ckgardner25/Venue_Decibel_Meter/Images/Front.png

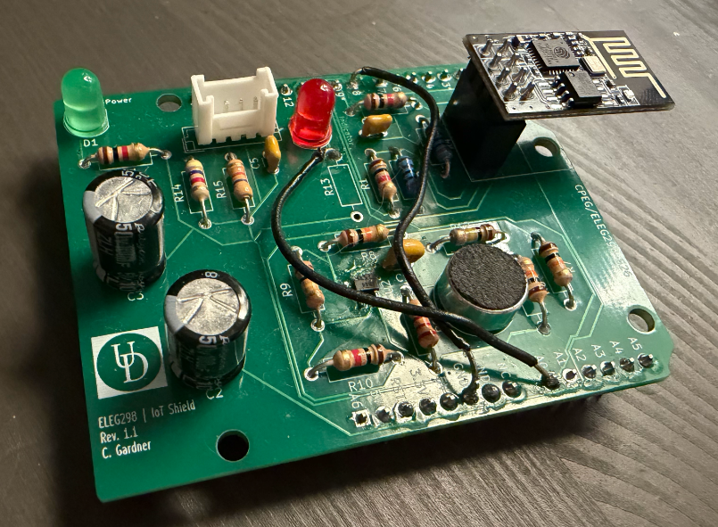
Images/Front.png
