ckgardner25/Venue_Decibel_Meter/Images/Rear.png

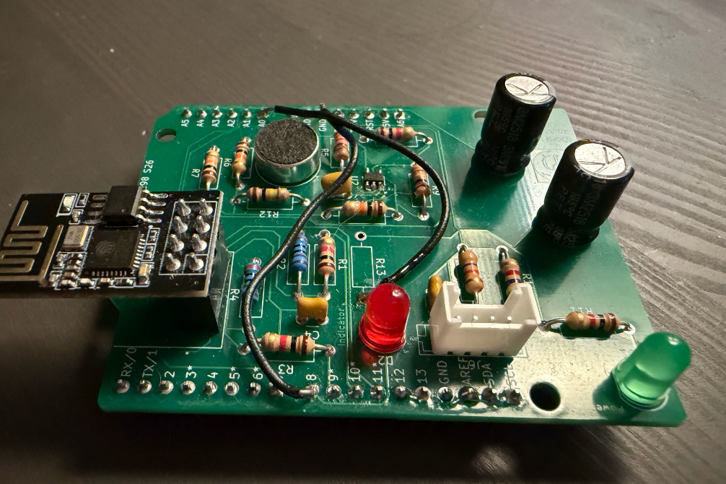
Images/Rear.png
