ckgardner25/Venue_Decibel_Meter/PCB/PCB.png

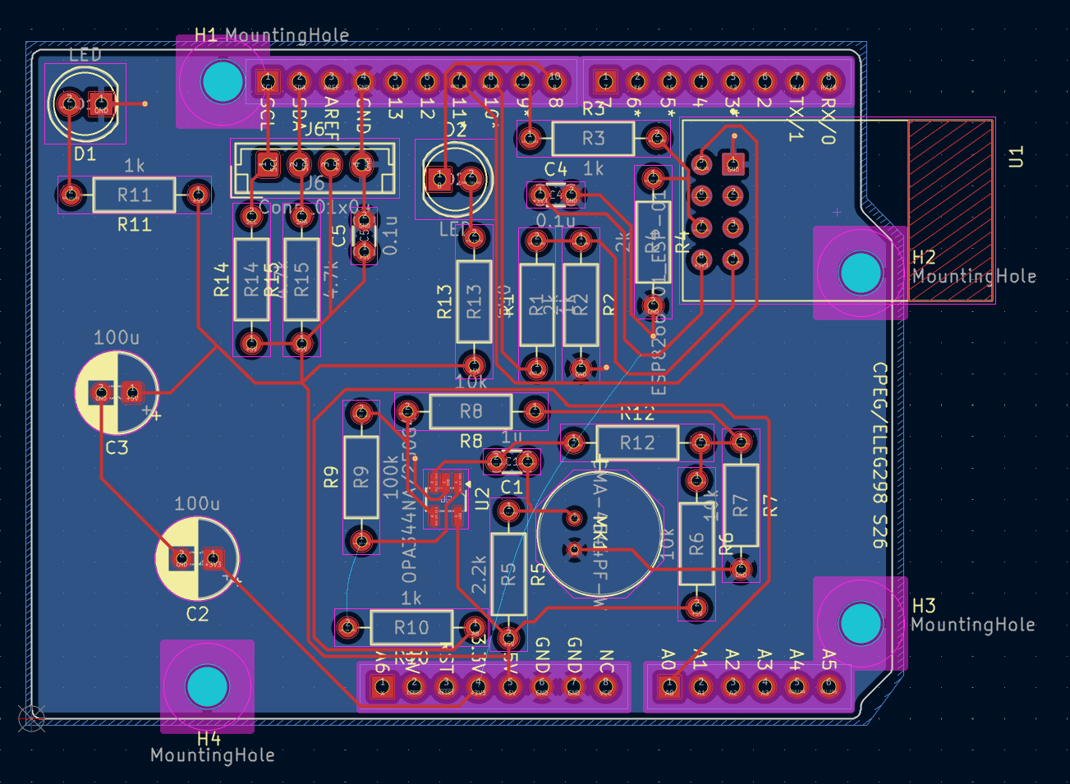
PCB/PCB.png
