ckgardner25/Venue_Decibel_Meter/Schematics/ESP8266 Module.png

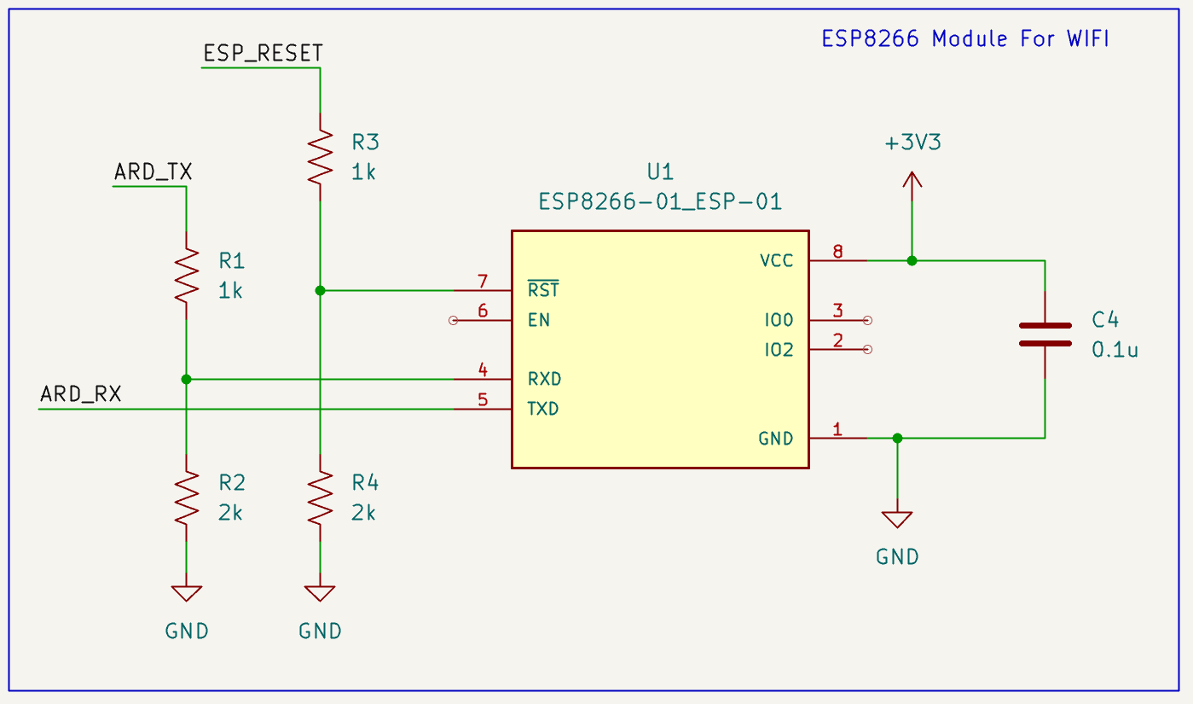
Schematics/ESP8266 Module.png
