ckgardner25/Venue_Decibel_Meter/Schematics/Expansion_Slot.png

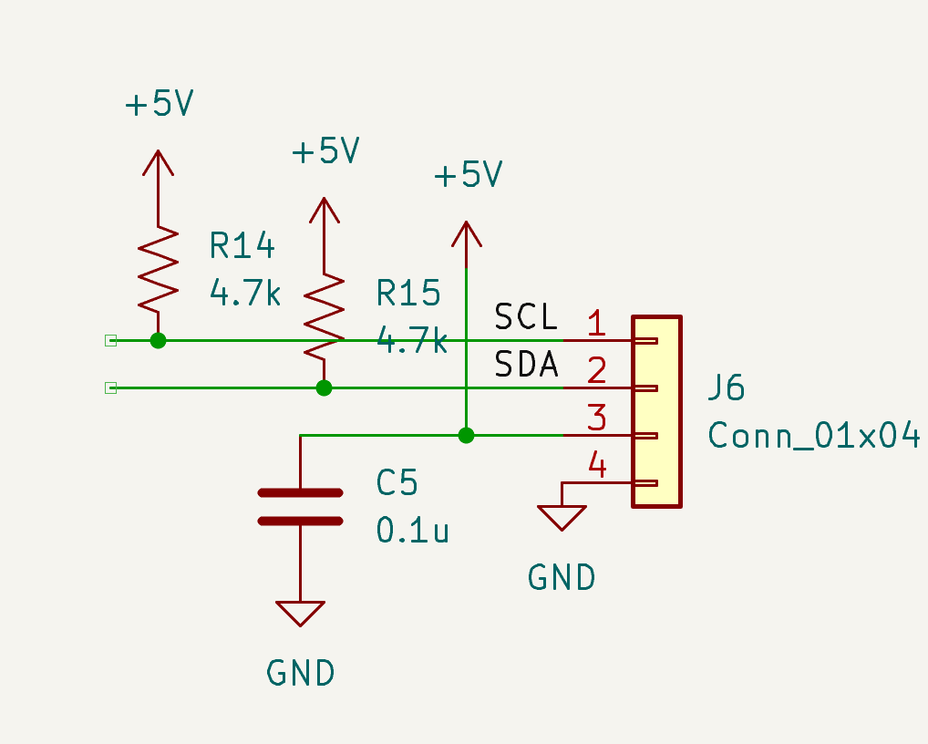
Schematics/Expansion_Slot.png
