ckgardner25/Venue_Decibel_Meter/Schematics/Input_Architecture.png

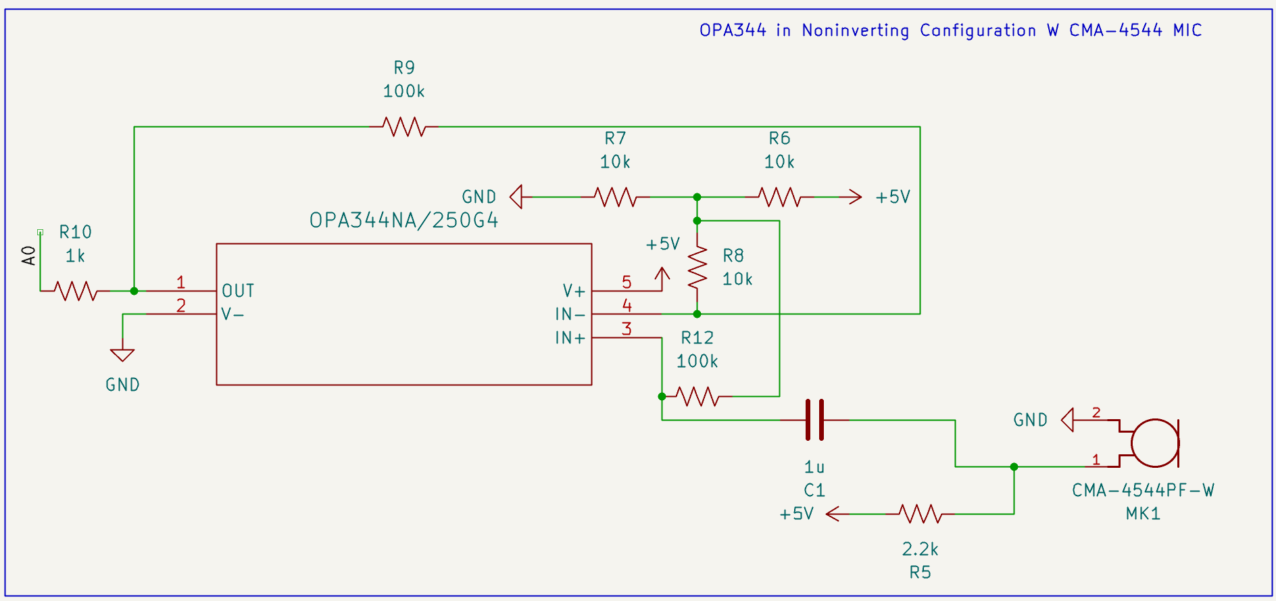
Schematics/Input_Architecture.png
