ckgardner25/Venue_Decibel_Meter/Reports/OscillscopeReadings_Schematics_BOM.pdf

# Venue Audio Monitor

### ELEG298 S26 IOT Device Christopher Gardner 4/29/2026

# Design Issues/Goals

Goals: • Design and Develop a venue audio monitor to comply with city

ordinance on volume
- Have expandable ports for future needs
- Upload via ESP8266 and show with a red LED when dB volume exceed 70+
Issue:
When designing the PCB I mistaken connected the indicator LED directly to 5V leading it to be unable to send a warning flash when too loud. However, as a prototype I designed the LED in a way so that removing R13 and wiring the LED straight to the analog pinout for the mic (A0) to have full functionality.

# Schematic and Description

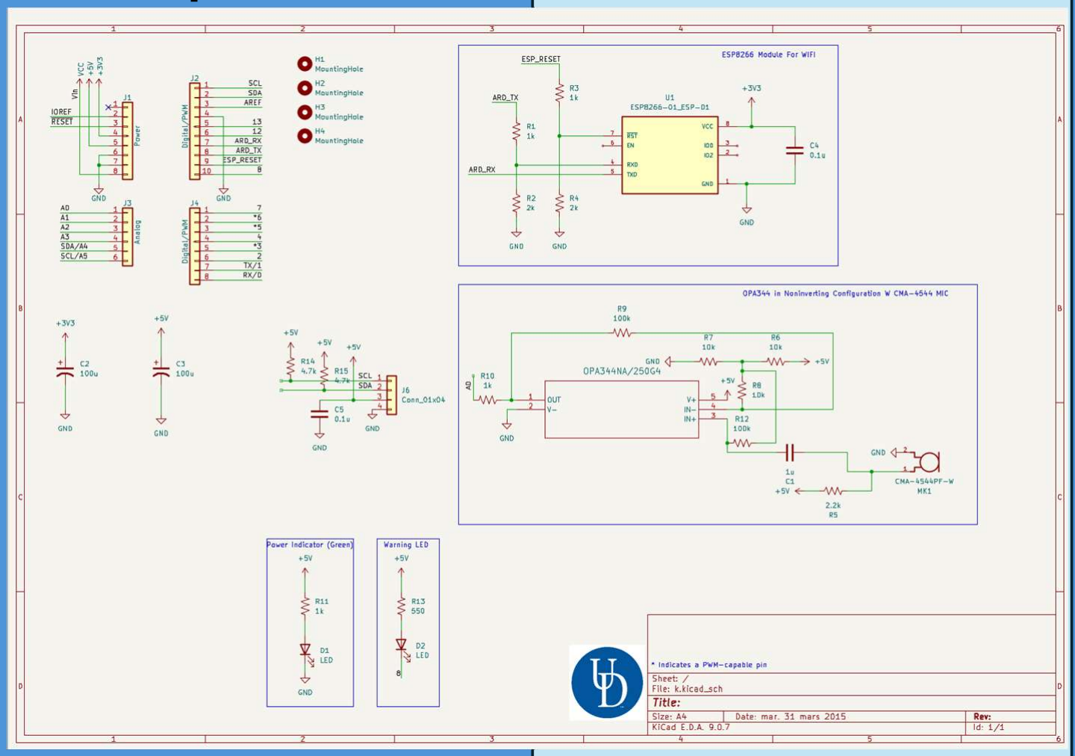
[picture p18: figure]

The IoT shield takes a audio impute via the microphone and boosts the AC signal into a operational amplifier wired in non-inverting bias to create the maximum AC output. This is then taken into the ADC to be processed as a digital signal for the ESP8266 to then take the average of peak-to-peak waves for the conversion to dB for accurate readings. The direct AC signal is also put into the indicator LED to show when the dB exceeds threshold value.

# Operational Amplifier/Microphone Datasheet

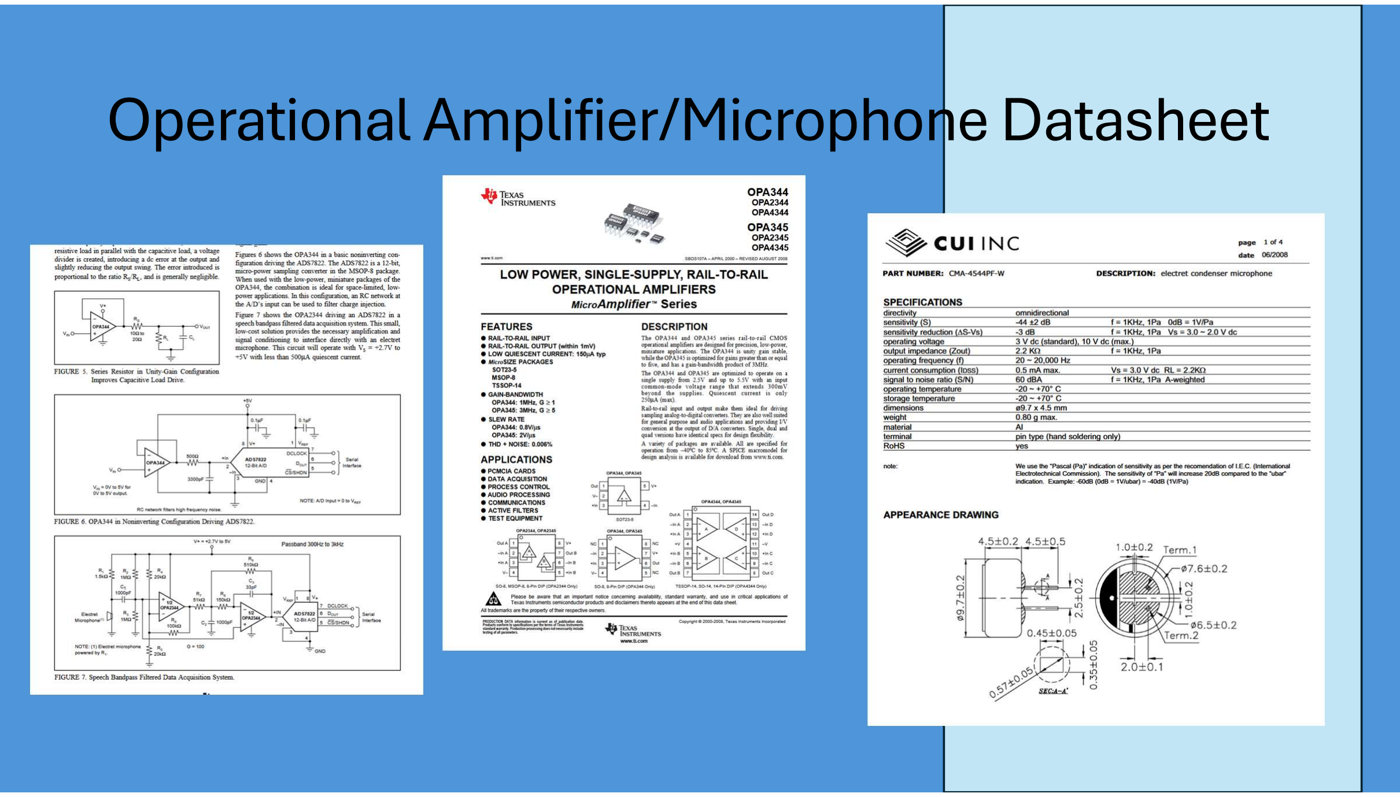
[picture p19: page 4]

# PCB Design

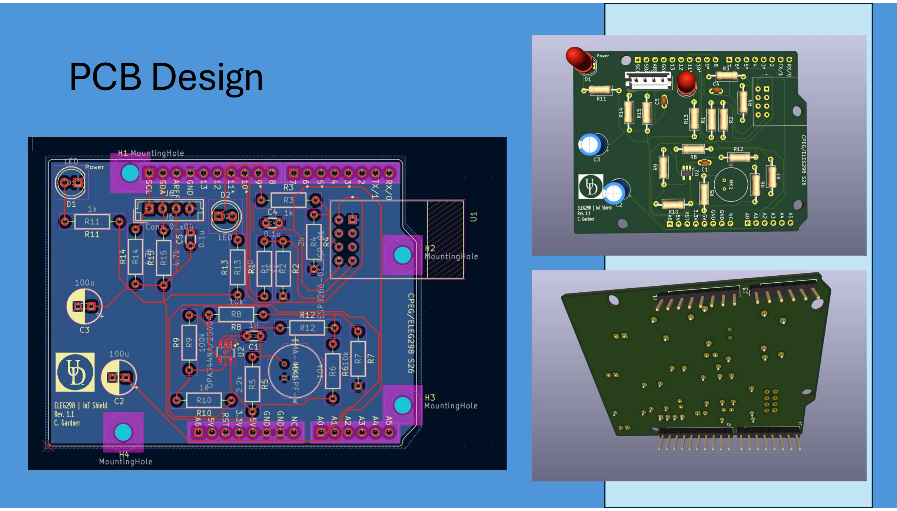
[picture p20: page 5]

# BOM/Stuffing Diagram

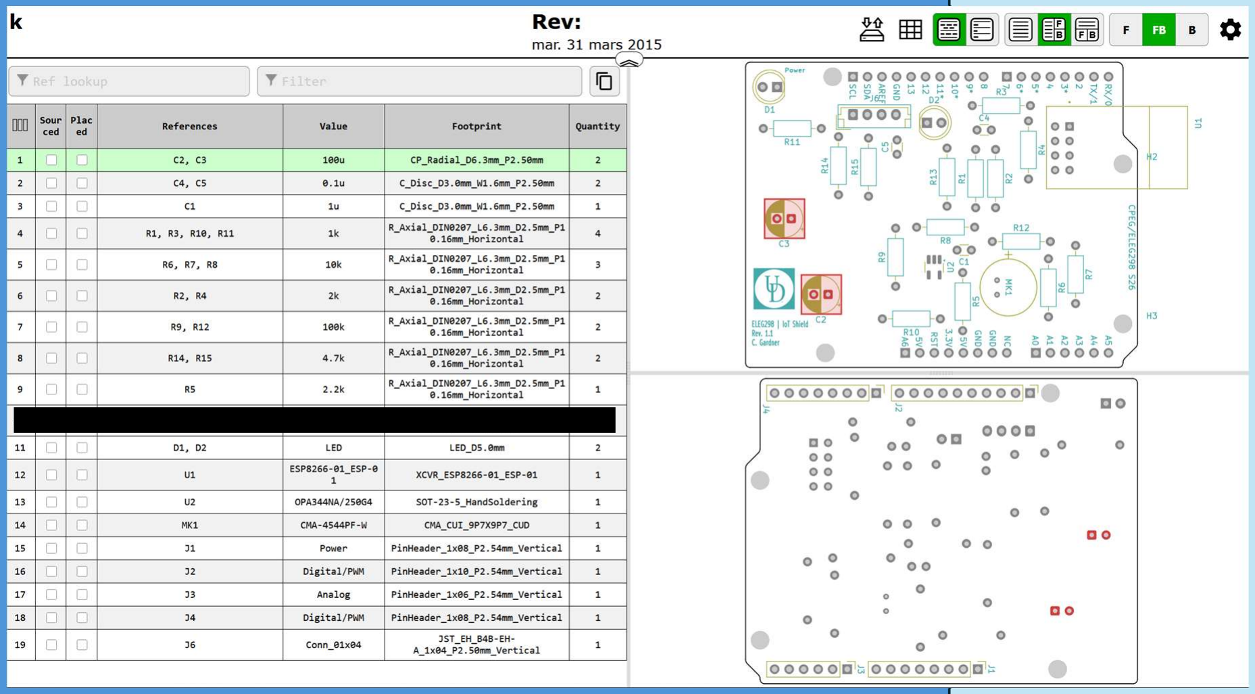
[picture p21: figure]

# Arduino Code

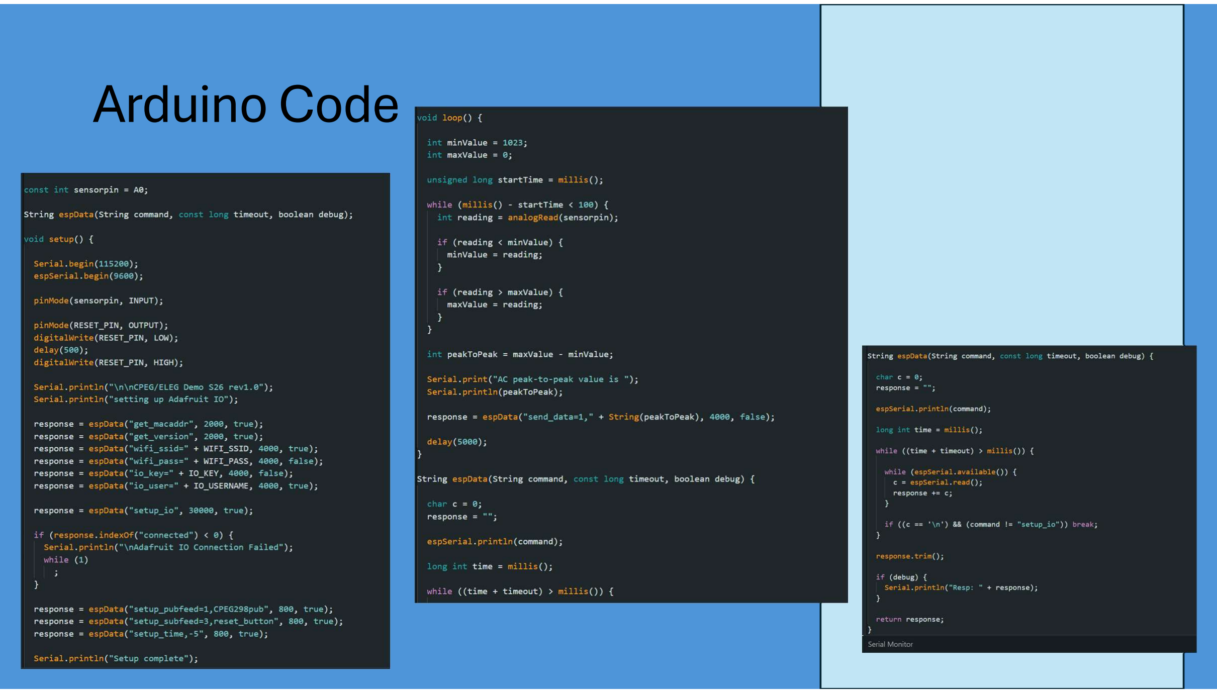
[picture p22: page 7]

# Oscilloscope Readings from impulses

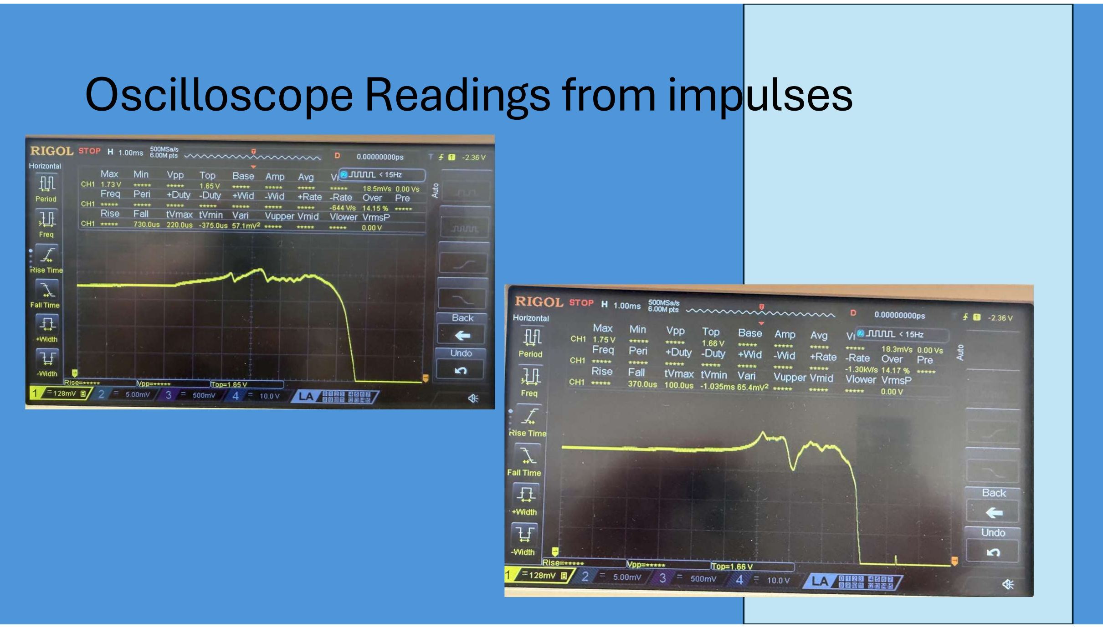
[picture p23: page 8]

# Adafruit Dashboard

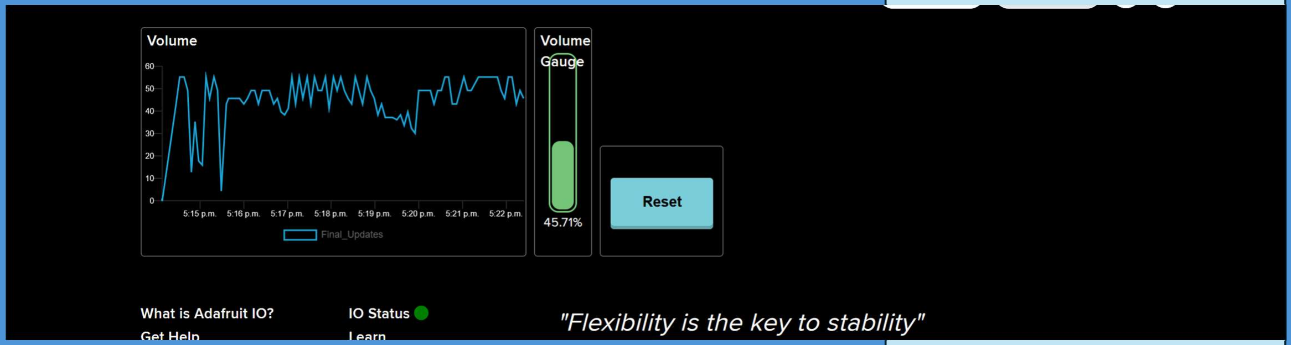
[picture p24: figure]

# Demo
